Ye-Shaiyoe/MONITORING_ESP32C5_REALTIME/(commit log)

2026-06-30 Swap RX1 and TX1 pin definitions
    [ESP32-C5_WeatherStation_LAB_K46-FIX.ino]
2026-07-06 Untuk ESP32-C5_WeatherStation_LAB_C.ino bagian Lab C
2026-07-08 Update and rename ESP32-C5_WeatherStation_LAB_B to ESP32-C5_WeatherStation_LAB_B.ino
2026-07-09 Refactor weather station code for clarity and performance
    Refactor ESP32 weather station code to improve structure and readability, including adding watchdog timer, updating sensor data parsing, and enhancing WiFi connection logic.
2026-07-12 Update README with LCD and ESP43 PIN connections LCD AND ESP32
    Added a section for PIN connections between LCD and ESP43.
2026-07-14 fix bug: lcd timeout and Refactor weather station code and improve HTTP handling
    [ESP32-C5_WeatherStation_LAB_K46-FIX.ino]
2026-07-14 fix: fix lcd blank, and clean code
    [ESP32-C5_WeatherStation_LAB_K46-FIX.ino]
2026-07-15 Create ESP32-C5_ALL_LAB
2026-07-15 Update ESP32-C5_ALL_LAB
2026-07-23 Integrasi Dari FLUKE 1620A H DawK THERMO-HYGROMETER ke dalam Arduino ESP32-C5
2026-07-29 Fix: penmabahan agar mendeteksi Tekanan dan Added functionality to read data from Fluke 1620A hygrometer and display it on an LCD. Implemented WiFi connectivity and HTTP data transmission..
    [ESP32_C5_FIX_FLUKE_HYGROMETER.ino]
2026-08-24 Fix: beberapa bug di integrasi esp32C5 ke FLUKE HYGROMTER
    [ESP32_C5_FIX_FLUKE_HYGROMETER.ino]
2026-08-31 Adding complete migration documentation for the ESP32-C5 project.
2026-08-31 Update project documentation Adding complete migration documentation for the ESP32-C5 project. in README.md
